seismicindustries/spink0/hardware/spink0_adaption/060_spink0_MB/pics/PI-Zero-W.jpg

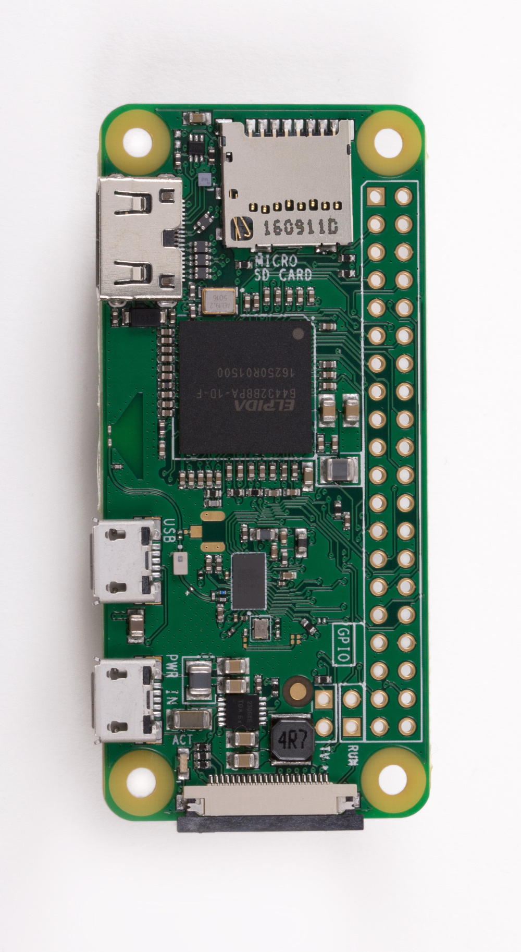
hardware/spink0_adaption/060_spink0_MB/pics/PI-Zero-W.jpg
