seismicindustries/spink0/README.md

# spink0
Pic of the PCB with Panel and displayboard

This repository contains the source code and the schematics for an Ableton Link to clock/reset converter.
