seismicindustries/spink0/support/modeswitch/README.md

this directory contains all additional scripts from raffi / luki for the spink0

wlan-mode.sh  	is registered as service so the mode switching can be achieved. 
		depending on where you wanna move it. you have to adapt paths. 

addnet.php / tar	is a script to be put into var/www/html to enable to enter credentials for new networks for
			opearation in client mode.
