seismicindustries/spink0/hardware/spink0_adaption/060_spink0_DB/spink0_DB.jpg

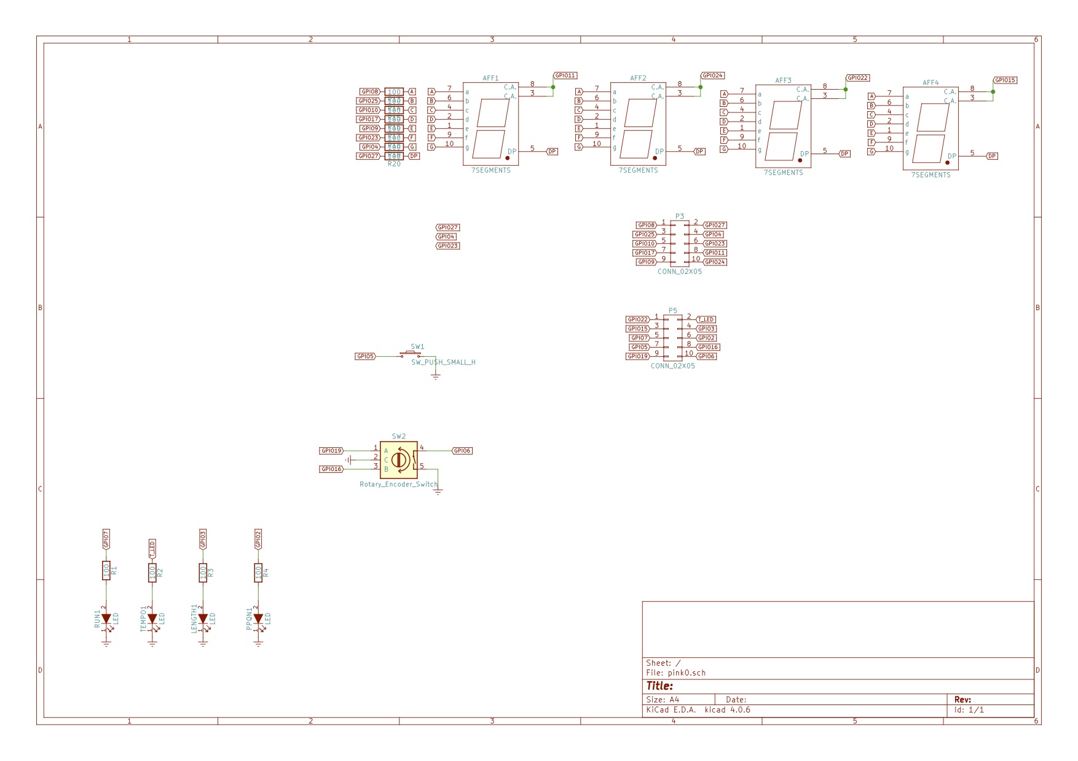
hardware/spink0_adaption/060_spink0_DB/spink0_DB.jpg
