seismicindustries/spink0/hardware/spink0_adaption/060_spink0_MB/spink0_MB.jpg

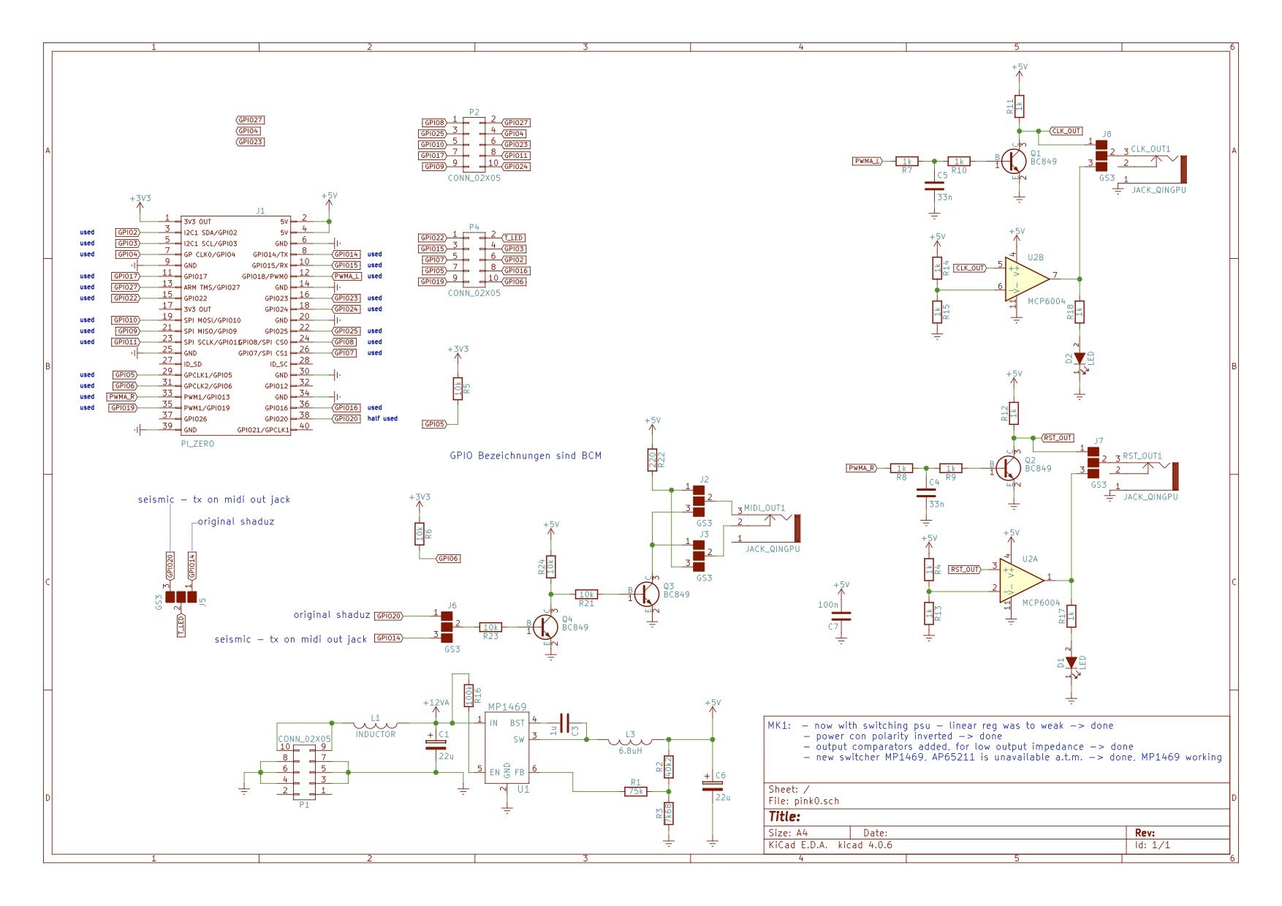
hardware/spink0_adaption/060_spink0_MB/spink0_MB.jpg
