seismicindustries/spink0/hardware/spink0_adaption/060_spink0_DB/pink0_DB_BOM.csv

Refs | Value | Footprint | QTY | MFR | MPN | SPR | SPN
RUN1;TEMPO1;LENGTH1;PPQN1 | LED | LEDs:LED_0805 | 4 | Avago / Broadcom | HSMH-C170 | Mouser | 630-HSMH-C170
AFF1;AFF2;AFF3;AFF4 | 7SEGMENTS | raffilibkicad:ACSA02_KCSA02_7segment | 4 | Kingbright | ACSA02-41YWA-F01 | Mouser | 604-ACSA02-41YWA
SW1 | SW_PUSH_SMALL_H | raffilibkicad:APEM_tactile_SMD_switch_6mm | 1 | APEM | ADTSM66NV | Mouser | 642-ADTSM66NV
SW2 | Rotary_Encoder_Switch | raffilibkicad:ENCODER_PEC11_SMD | 1 | Bourns | PEC11S-929K-S0015 | Mouser | 652-PEC11S9215KH0015
P3;P5 | CONN_02X05 | raffilibkicad:PINHEAD_10_pin_jtag_connector | 2 | Amphenol FCI | 20021111-00010T4LF | Mouser | 649-221111-00010T4LF
R1;R2;R3;R4;R13;R14;R15;R16;R17;R18;R19;R20 | 100 | raffilibkicad:R_0805 | 12 | Yageo | RC0805FR-07100RL | Mouser | 603-RC0805FR-07100RL
