seismicindustries/spink0/hardware/spink0_adaption/060_spink0_DB/pink0.pdf

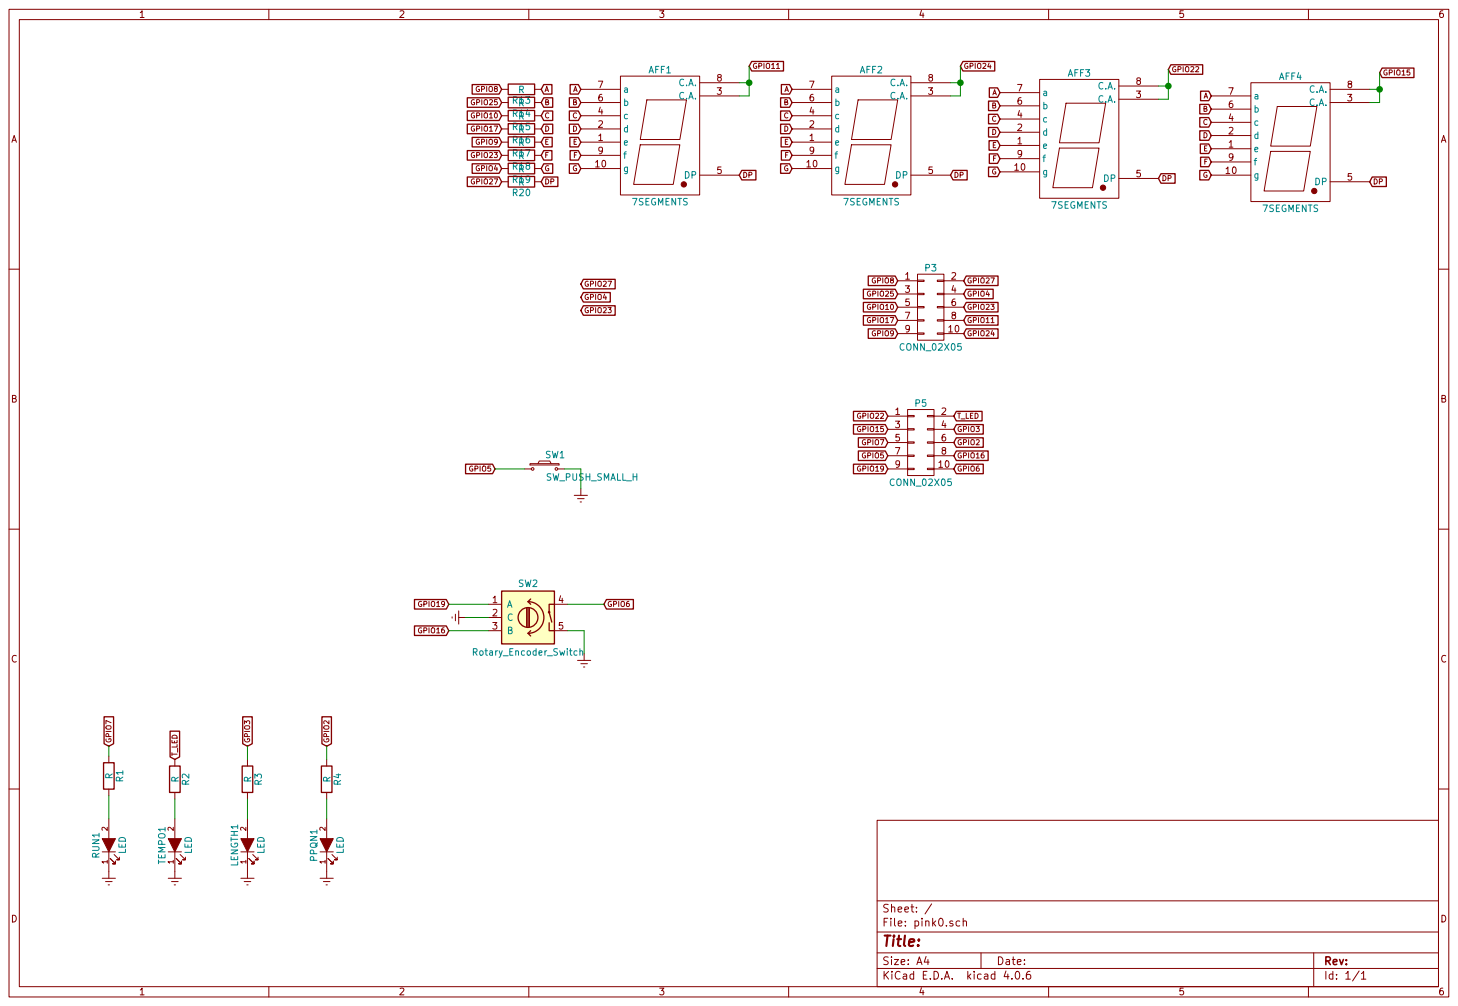
[picture p4: page 1]
