seismicindustries/spink0/hardware/spink0_adaption/060_spink0_MB/pink0.pdf

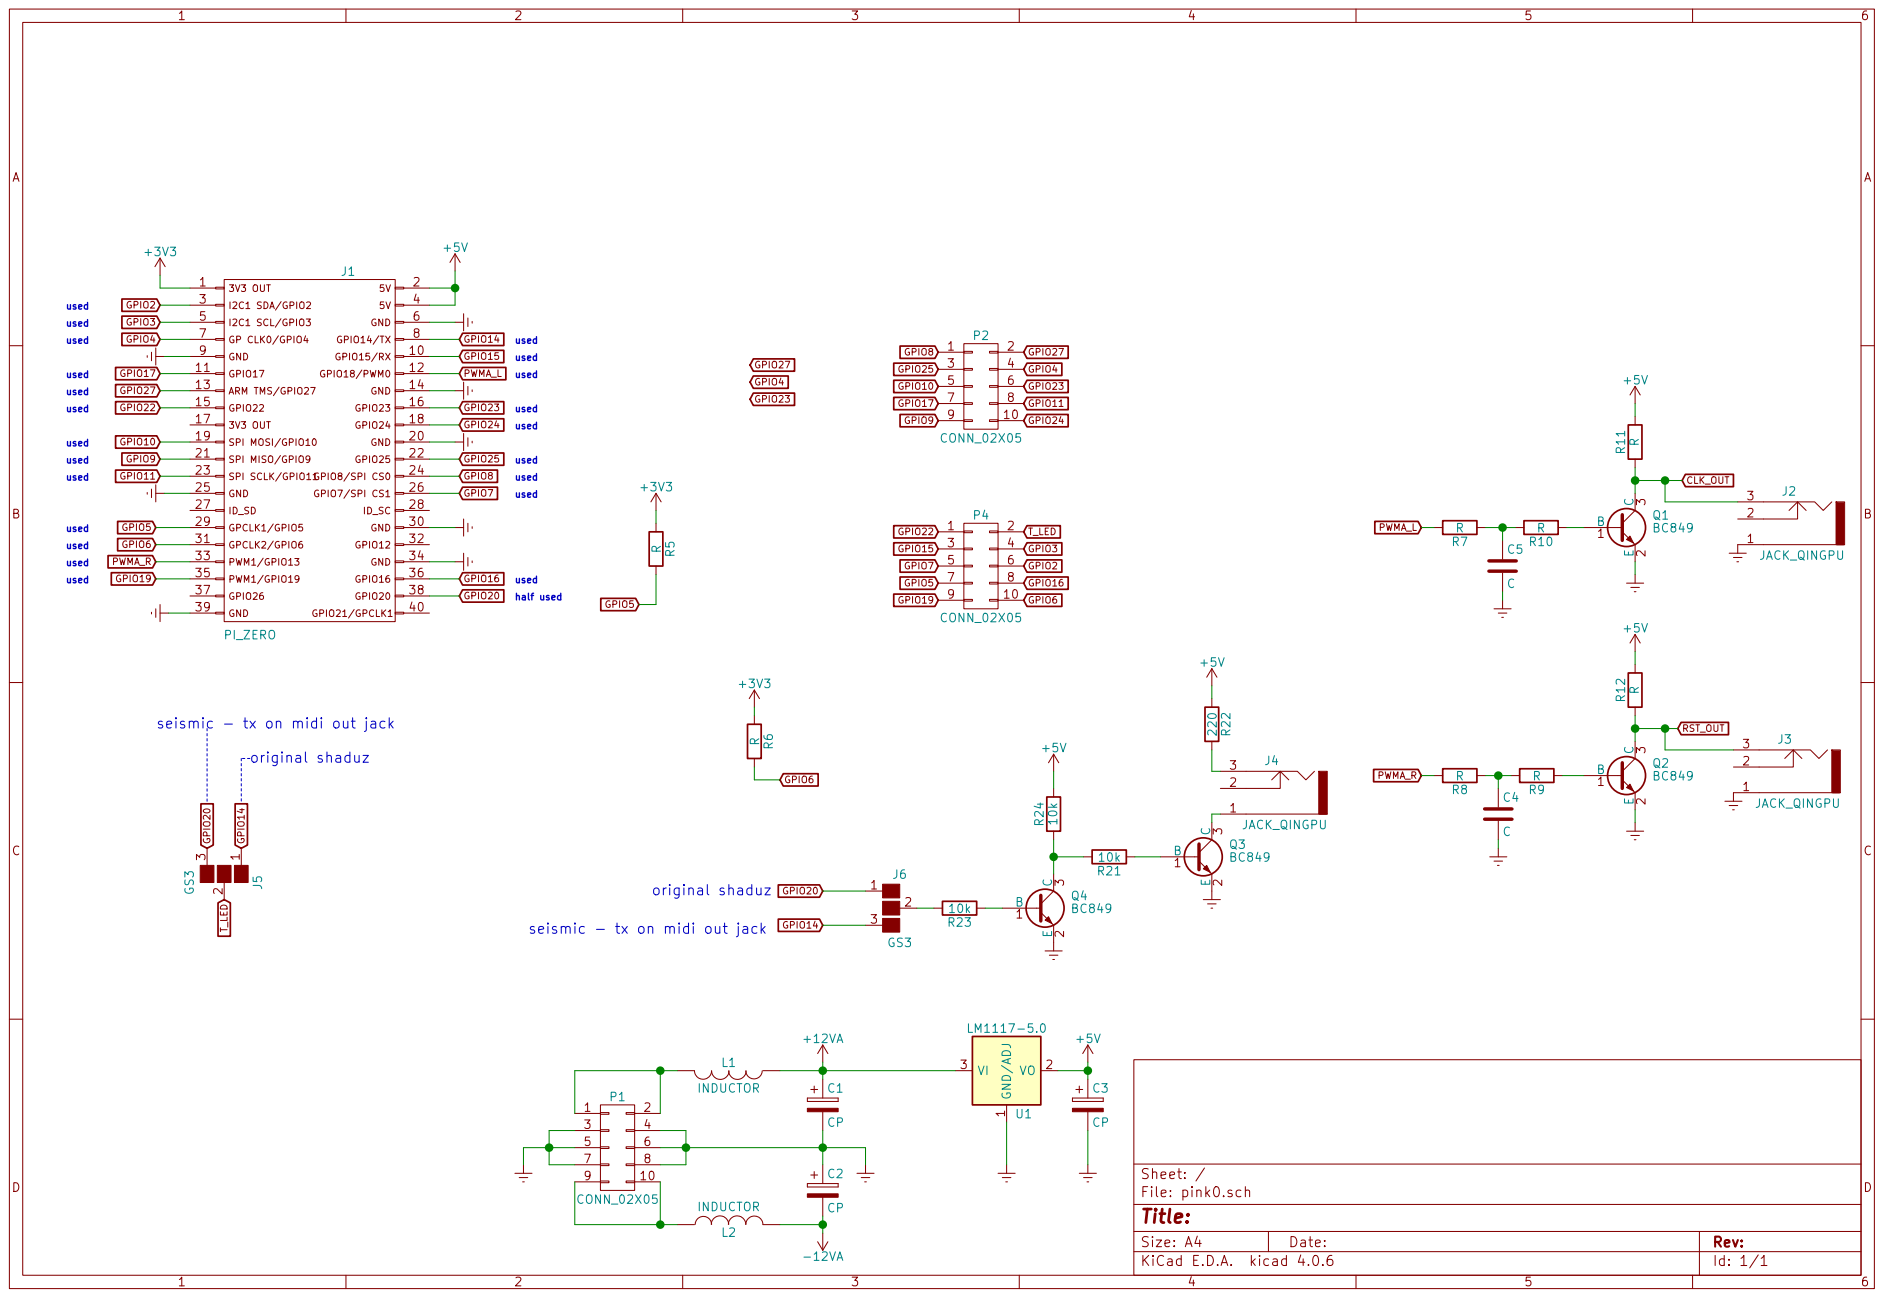
[picture p5: page 1]

seismic - tx on midi out jack
