seismicindustries/spink0/hardware/spink0_adaption/060_spink0_MB/spink0_MB.pdf

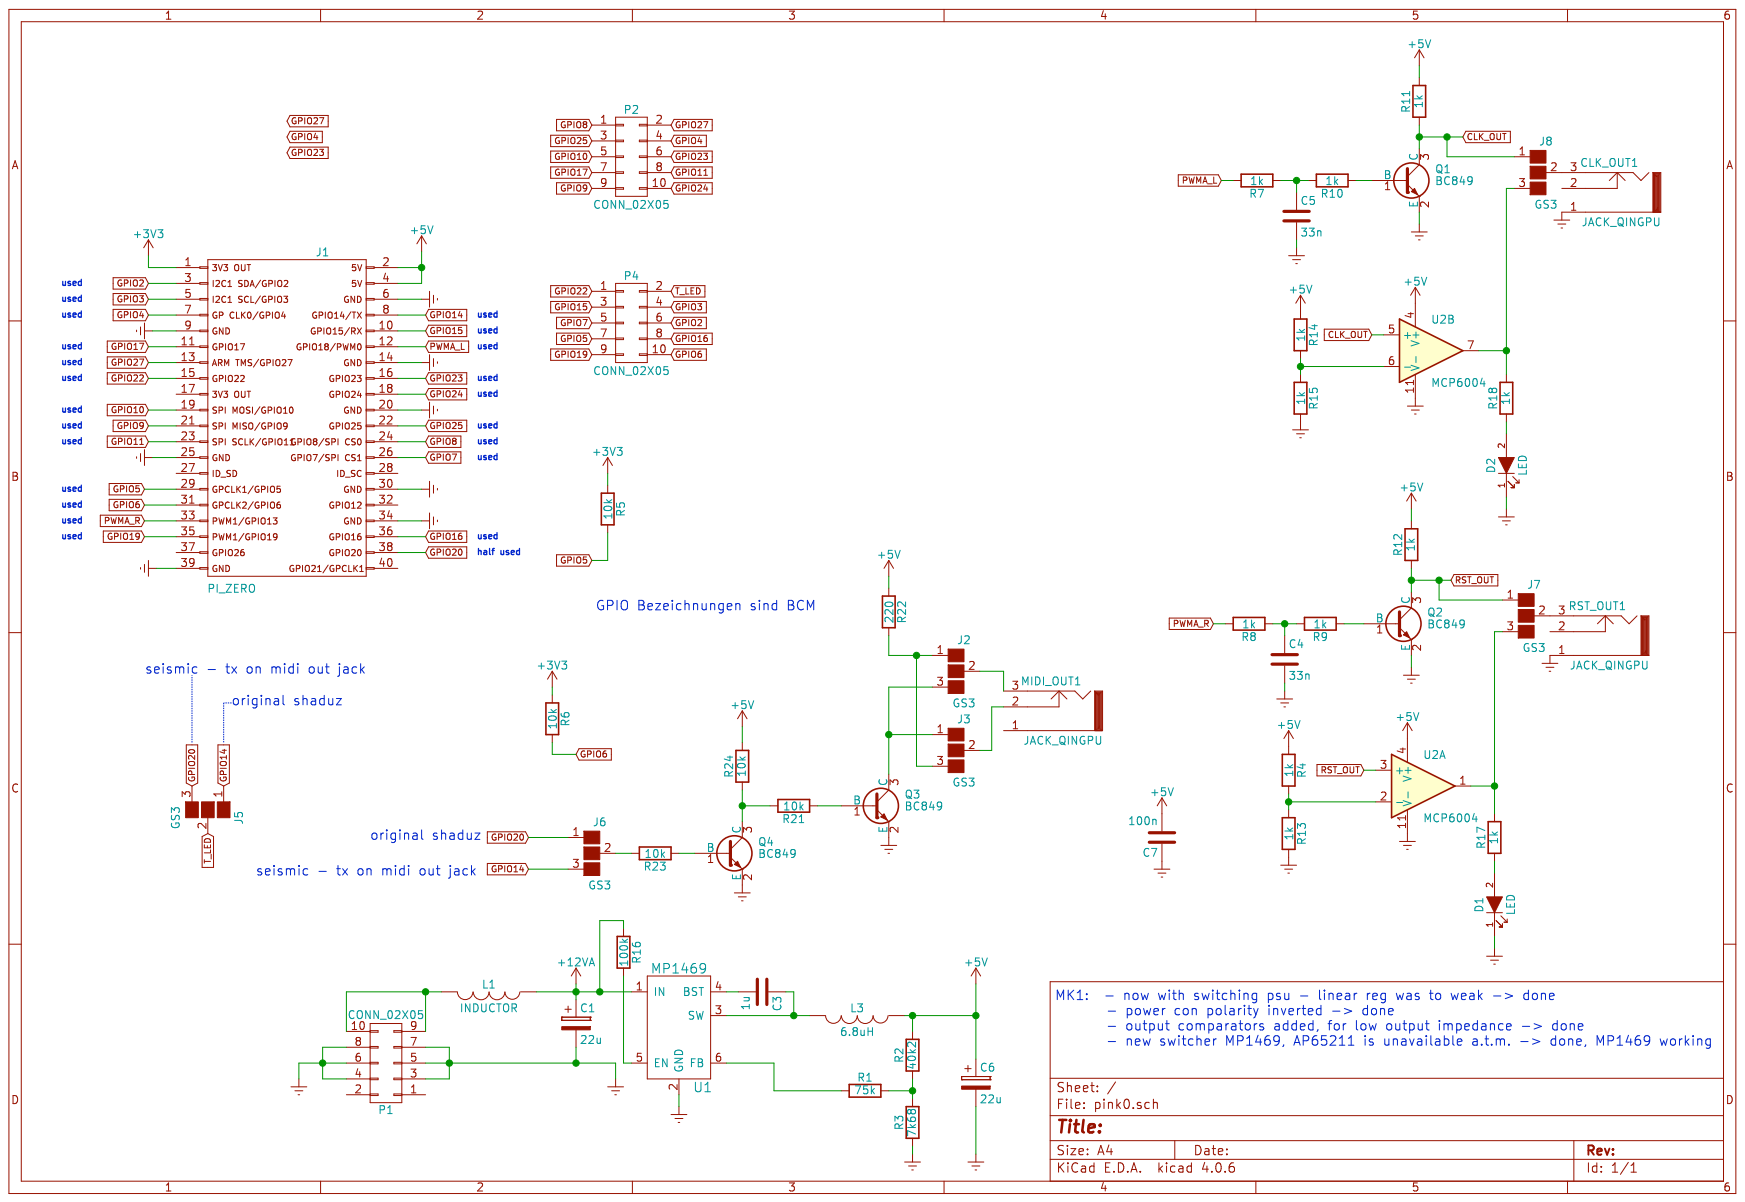
[picture p6: page 1]
