seismicindustries/spink0/hardware/spink0_adaption/060_spink0_DB/pink0.kicad_pcb

## KiCad design hardware/spink0_adaption/060_spink0_DB/pink0.kicad_pcb (2018-02-20)

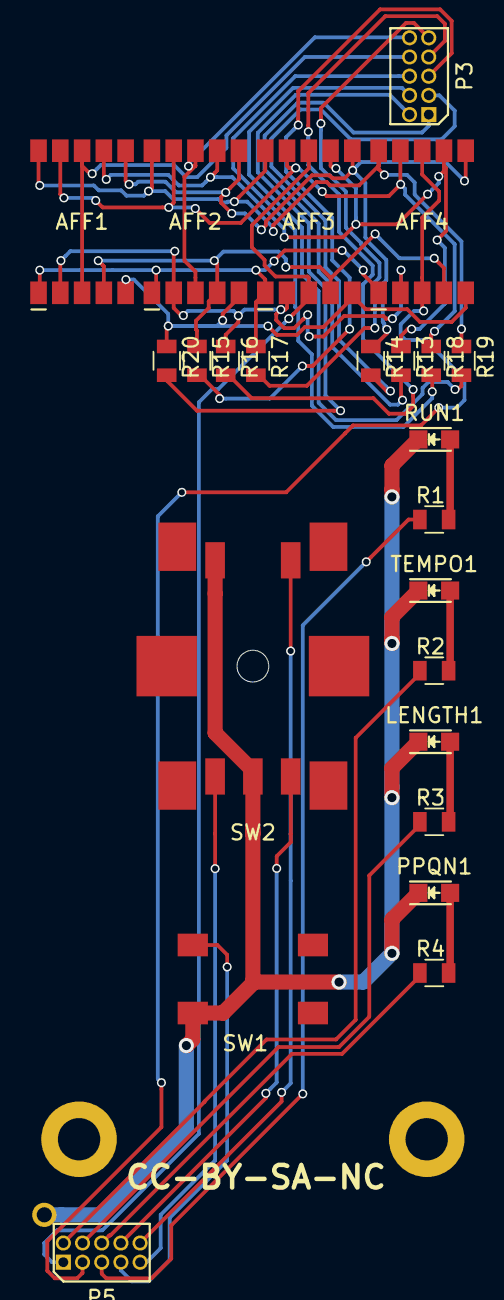
[picture p7: board hardware/spink0_adaption/060_spink0_DB/pink0.kicad_pcb from above]

Board: 2 copper layers, 24 parts (0 on the bottom side), 33 nets.

Parts:
AFF1, AFF2, AFF3, AFF4: 7SEGMENTS; ACSA02_KCSA02_7segment
LENGTH1: LED; LED_0805
P3, P5: CONN_02X05; PINHEAD_10_pin_jtag_connector
PPQN1: LED; LED_0805
R1, R2, R3, R4, R13, R14, R15, R16, R17, R18, R19, R20: R; R_0805
RUN1: LED; LED_0805
SW1: SW_PUSH_SMALL_H; APEM_tactile_SMD_switch_6mm
SW2: Rotary_Encoder_Switch; ENCODER_PEC11_SMD
TEMPO1: LED; LED_0805

Connections:
A: AFF1.7, AFF2.7, AFF3.7, AFF4.7, R13.1
B: AFF1.6, AFF2.6, AFF3.6, AFF4.6, R14.1
C: AFF1.4, AFF2.4, AFF3.4, AFF4.4, R15.1
D: AFF1.2, AFF2.2, AFF3.2, AFF4.2, R16.1
DP: AFF1.5, AFF2.5, AFF3.5, AFF4.5, R20.1
E: AFF1.1, AFF2.1, AFF3.1, AFF4.1, R17.1
Earth: LENGTH1.1, PPQN1.1, RUN1.1, SW1.2, SW2.2, SW2.5, TEMPO1.1
F: AFF1.9, AFF2.9, AFF3.9, AFF4.9, R18.1
G: AFF1.10, AFF2.10, AFF3.10, AFF4.10, R19.1
GPIO2: P5.6, R4.1
GPIO3: P5.4, R3.1
GPIO4: P3.4, R19.2
GPIO5: P5.7, SW1.1
GPIO6: P5.10, SW2.4
GPIO7: P5.5, R1.1
GPIO8: P3.1, R13.2
GPIO9: P3.9, R17.2
GPIO10: P3.5, R15.2
GPIO11: AFF1.3, AFF1.8, P3.8
GPIO15: AFF4.3, AFF4.8, P5.3
GPIO16: P5.8, SW2.3
GPIO17: P3.7, R16.2
GPIO19: P5.9, SW2.1
GPIO22: AFF3.3, AFF3.8, P5.1
GPIO23: P3.6, R18.2
GPIO24: AFF2.3, AFF2.8, P3.10
GPIO25: P3.3, R14.2
GPIO27: P3.2, R20.2
unnamed: LENGTH1.2, R3.2
unnamed: PPQN1.2, R4.2
unnamed: R1.2, RUN1.2
unnamed: R2.2, TEMPO1.2
T_LED: P5.2, R2.1
