seismicindustries/spink0/hardware/spink0_adaption/060_spink0_MB/pink0.kicad_pcb

## KiCad design hardware/spink0_adaption/060_spink0_MB/pink0.kicad_pcb (2018-02-20)

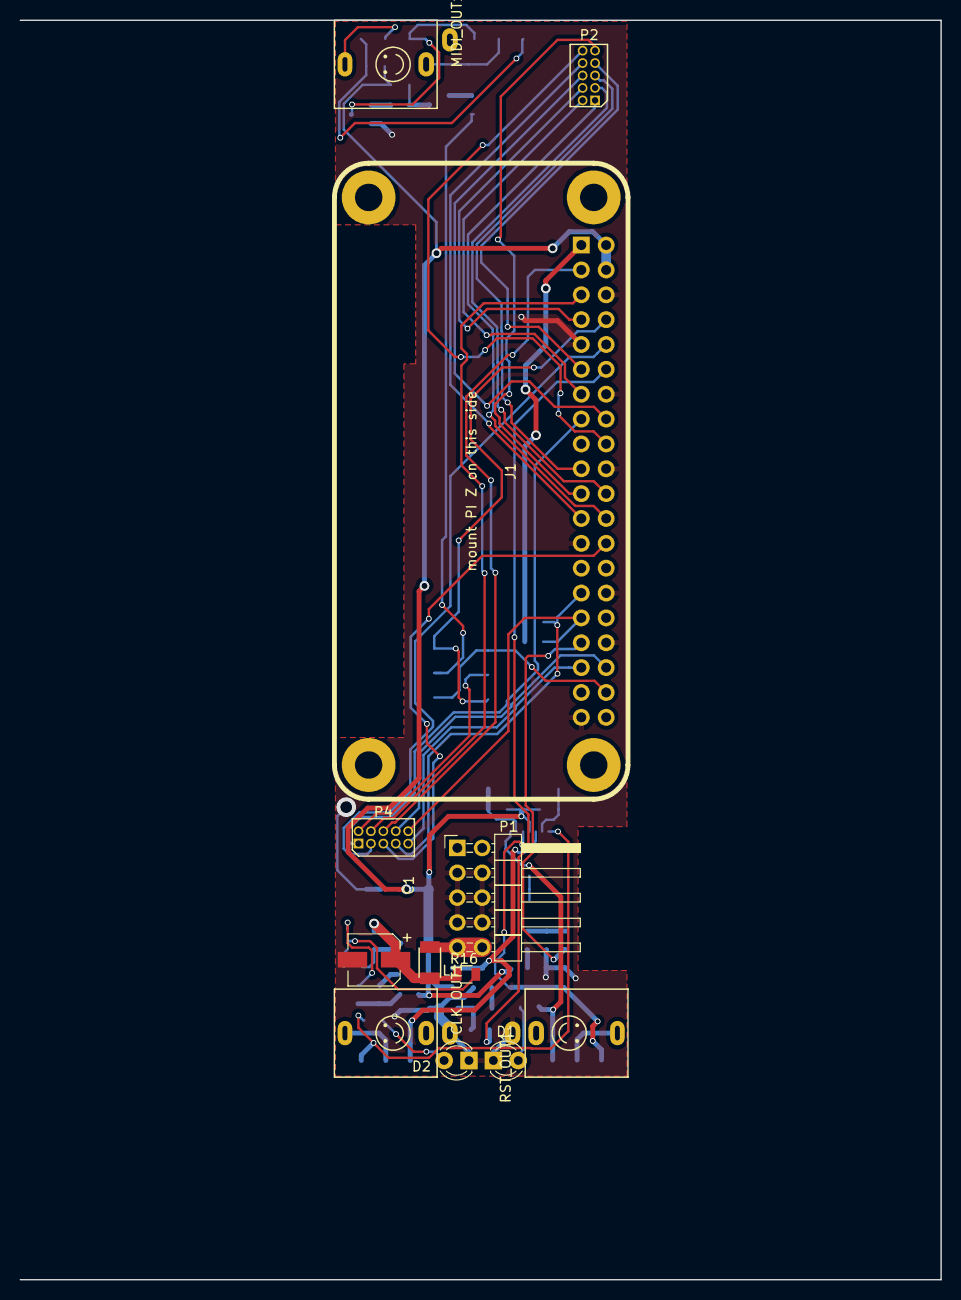
[picture p8: board hardware/spink0_adaption/060_spink0_MB/pink0.kicad_pcb from above]

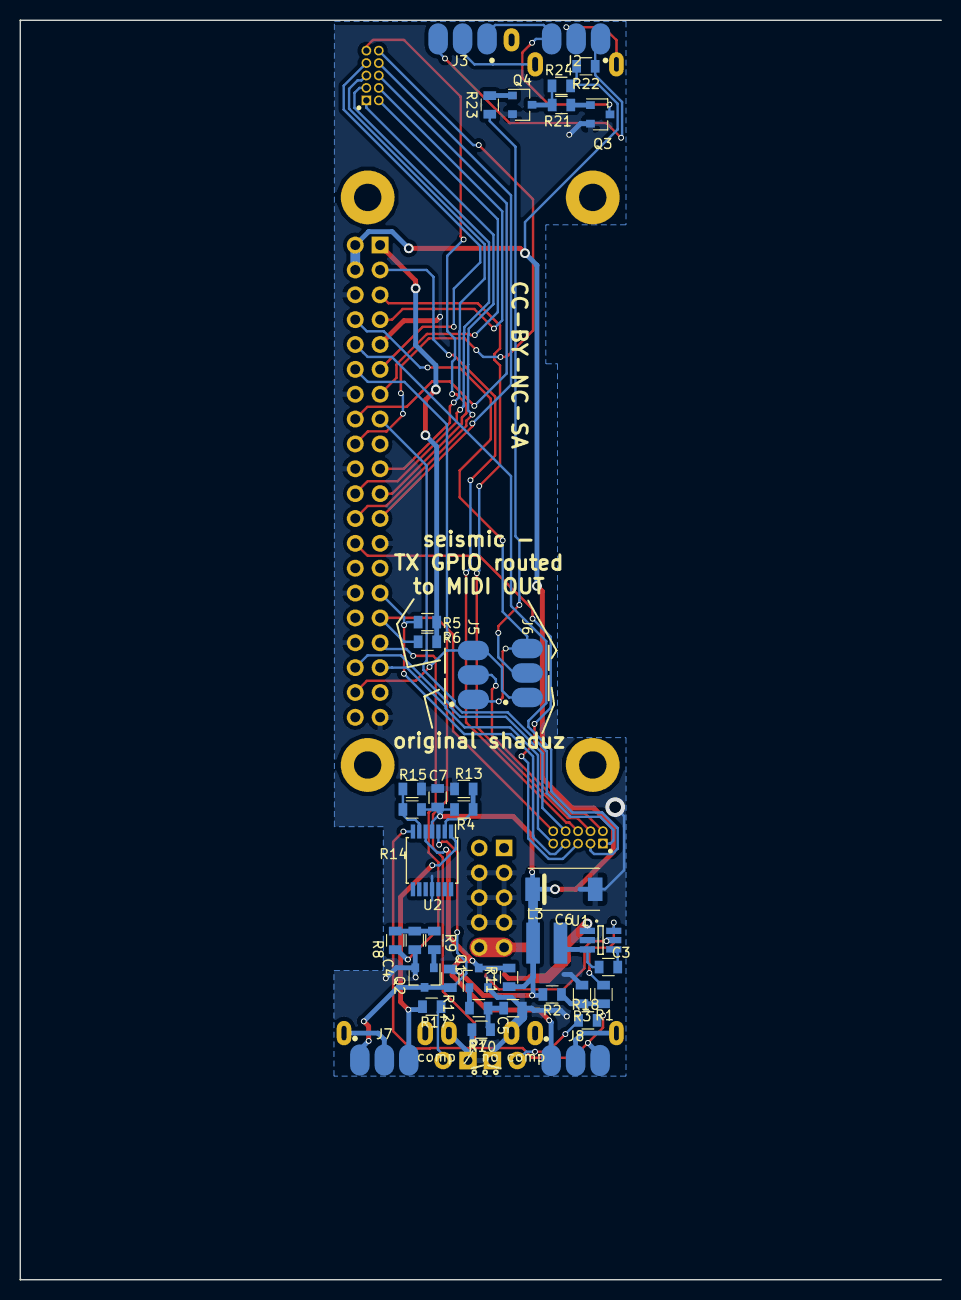
[picture p9: board hardware/spink0_adaption/060_spink0_MB/pink0.kicad_pcb from below]

Board: 2 copper layers, 94.1 x 128.7 mm, 51 parts (39 on the bottom side), 56 nets.

Parts:
C1: 22u; CP_Elec_5x5.3
C3: 1u; C_0805
C4, C5: 33n; C_0805
C6: 22u; CP_Elec_7.3x4.3
C7: 100n; C_0805
CLK_OUT1: JACK_QINGPU; jack_qingpu
D1, D2: LED; LED_D3.0mm
J1: PI_ZERO
J2, J3, J5, J6, J7, J8: GS3; solderbridge
L1: INDUCTOR; Inductor_PSU_NLCV32T
L3: 6.8uH; Inductor_SRN4018TA_bourns
MIDI_OUT1: JACK_QINGPU; jack_qingpu
P1: CONN_02X05; Pin_Header_Angled_2x05_Pitch2.54mm_with_space_for_con
P2, P4: CONN_02X05; PINHEAD_10_pin_jtag_connector
Q1, Q2, Q3, Q4: BC849; SOT-23
R1: 75k; R_0805
R2: 40k2; R_0805
R3: 7k68; R_0805
R4, R7, R8, R9, R10, R11, R12, R13, R14, R15, R17, R18: 1k; R_0805
R5, R6, R21, R23, R24: 10k; R_0805
R16: 100k; R_0805
R22: 220; R_0805
RST_OUT1: JACK_QINGPU; jack_qingpu
U1: MP1469; SOT-23-6
U2: MCP6004; TSSOP-14_4.4x5mm_Pitch0.65mm

Connections:
+3V3: J1.1, R5.1, R6.1
+5V: C6.1, C7.2, J1.2, J1.4, L3.1, R2.2, R4.1, R11.2, R12.2, R14.1, R22.1, R24.2, U2.4
+12VA: C1.1, L1.1, R16.1, U1.1
CLK_OUT: J8.1, Q1.3, R11.1, U2.5
Earth: C1.2, C4.2, C5.2, C6.2, C7.1, CLK_OUT1.1, D1.1, D2.1, J1.6, J1.9, J1.14, J1.20, J1.25, J1.30, J1.34, J1.39, P1.3, P1.4, P1.5, P1.6, P1.7, P1.8, Q1.2, Q2.2, Q3.2, Q4.2, R3.1, R13.2, R15.2, RST_OUT1.1, U1.2, U2.11
GPIO2: J1.3, P4.6
GPIO3: J1.5, P4.4
GPIO4: J1.7, P2.4
GPIO5: J1.29, P4.7, R5.2
GPIO6: J1.31, P4.10, R6.2
GPIO7: J1.26, P4.5
GPIO8: J1.24, P2.1
GPIO9: J1.21, P2.9
GPIO10: J1.19, P2.5
GPIO11: J1.23, P2.8
GPIO14: J1.8, J5.1, J6.3
GPIO15: J1.10, P4.3
GPIO16: J1.36, P4.8
GPIO17: J1.11, P2.7
GPIO19: J1.35, P4.9
GPIO20: J1.38, J5.3, J6.1
GPIO22: J1.15, P4.1
GPIO23: J1.16, P2.6
GPIO24: J1.18, P2.10
GPIO25: J1.22, P2.3
GPIO27: J1.13, P2.2
unnamed: C3.1, L3.2, U1.3
unnamed: C3.2, U1.4
unnamed: C4.1, R8.1, R9.2
unnamed: C5.1, R7.1, R10.2
unnamed: CLK_OUT1.3, J8.2
unnamed: D1.2, R17.1
unnamed: D2.2, R18.1
unnamed: J2.1, J3.3, R22.2
unnamed: J2.2, MIDI_OUT1.3
unnamed: J2.3, J3.1, Q3.3
unnamed: J3.2, MIDI_OUT1.2
unnamed: J6.2, R23.2
unnamed: J7.2, RST_OUT1.3
unnamed: J7.3, R17.2, U2.1
unnamed: J8.3, R18.2, U2.7
unnamed: L1.2, P1.9, P1.10
unnamed: Q1.1, R10.1
unnamed: Q2.1, R9.1
unnamed: Q3.1, R21.1
unnamed: Q4.1, R23.1
unnamed: Q4.3, R21.2, R24.1
unnamed: R1.1, U1.6
unnamed: R1.2, R2.1, R3.2
unnamed: R4.2, R13.1, U2.2
unnamed: R14.2, R15.1, U2.6
unnamed: R16.2, U1.5
PWMA_L: J1.12, R7.2
PWMA_R: J1.33, R8.2
RST_OUT: J7.1, Q2.3, R12.1, U2.3
T_LED: J5.2, P4.2
