seismicindustries/spink0/(commit log)

2018-02-20 moved mode switching script to support folder, src_raffi deleted, mode switch scipt added to crontab via installscript
2018-02-20 Hardware Sourcefiles added, fresh gerber MK1 merge added
2018-02-20 HW file upload, 2nd try..
    [pink0.kicad_pcb, pink0.sch, pink0_BOM_old.csv, pink0_DB_BOM.csv, pink0_DB_MK2_BOM.csv, pink0_FrontPanel.kicad_pcb, pink0_MB_and_DB_BOM.xlsx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]
2018-02-20 wrong BCM in comment 20 -> 28
    [UserInterfacePiZero.cpp]
