seismicindustries/spink0/(notices)

Notices in the files:
hardware/spink0_adaption/060_spink0_MB/merge/pink0_mergeMK1.kicad_pcb:
CC-BY-NC-SA
CC-BY-SA-NC
